JamesCarron/MixedSignalHWDesign/(commit log)

2023-03-23 Initial Component Layout
    Initial Component Layout
    [ADC.kicad_sch, ADC.sch, DAC.kicad_sch, DAC.sch, MCU.kicad_sch, MCU.sch, Nemesis-MixSigPCB.kicad_pcb, Nemesis-MixSigPCB.kicad_sch]
2023-03-23 Routed uController Basic Tracks
    [Nemesis-MixSigPCB.kicad_pcb]
2023-03-23 Initial Ground Pours done
    [Nemesis-MixSigPCB.kicad_pcb]
2023-05-23 Ignored KiCAD Backups Folder
    [Nemesis-MixSigPCB.kicad_pcb]
2023-05-23 Routed Digital Side of Board
    [Nemesis-MixSigPCB.kicad_pcb]
2023-05-23 Minor tweaks to digital side PCB routing
    [Nemesis-MixSigPCB.kicad_pcb]
2023-08-19 Completed Analog Routing
    [Nemesis-MixSigPCB.kicad_pcb]
2023-08-19 Remedied DRC issues
    Missing footprints and the following issue
    https://forum.kicad.info/t/drc-footprint-component-type-doesnt-match-footprint-pad/40404
    [Nemesis-MixSigPCB.kicad_pcb]
